farhan10904/lightweight-motor-bracket-fea/docs/01_Baseline_2D_Sketch.png

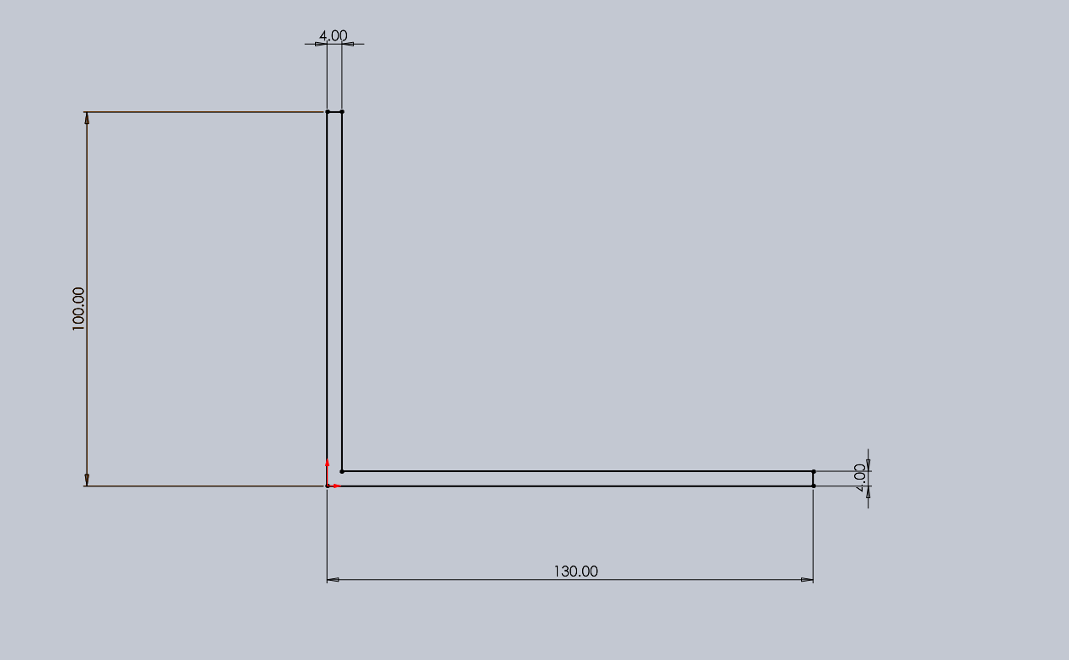
docs/01_Baseline_2D_Sketch.png
