farhan10904/lightweight-motor-bracket-fea/docs/09_Mass_Baseline_R0.png

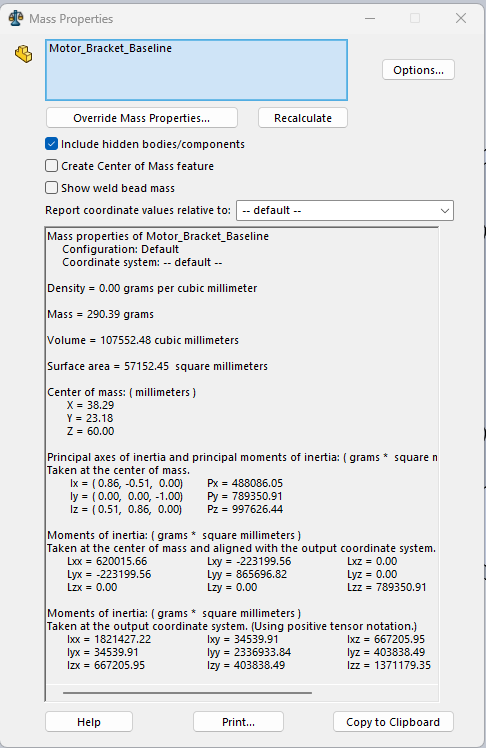
docs/09_Mass_Baseline_R0.png
