farhan10904/lightweight-motor-bracket-fea/docs/14_ANSYS_R0_Imported_Geometry.png

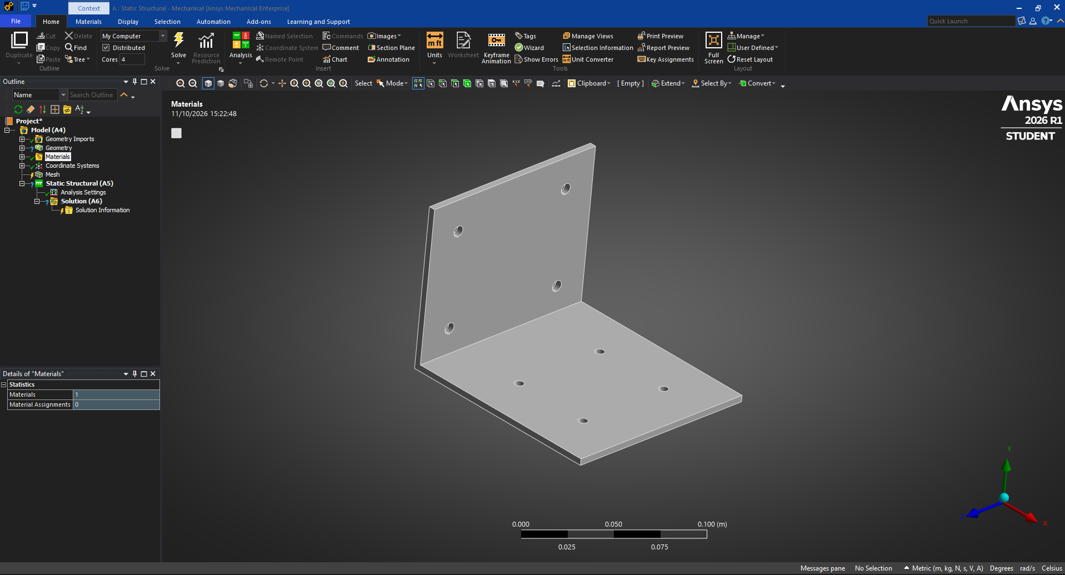
docs/14_ANSYS_R0_Imported_Geometry.png
