farhan10904/lightweight-motor-bracket-fea/docs/16_ANSYS_R0_Initial_Mesh.png

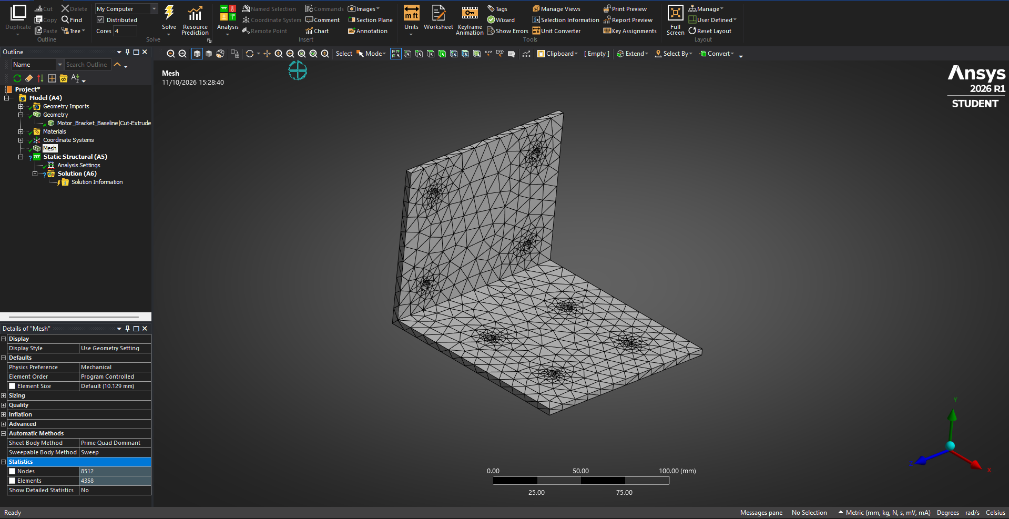
docs/16_ANSYS_R0_Initial_Mesh.png
