farhan10904/lightweight-motor-bracket-fea/docs/21_ANSYS_R0_Mesh_6mm.png

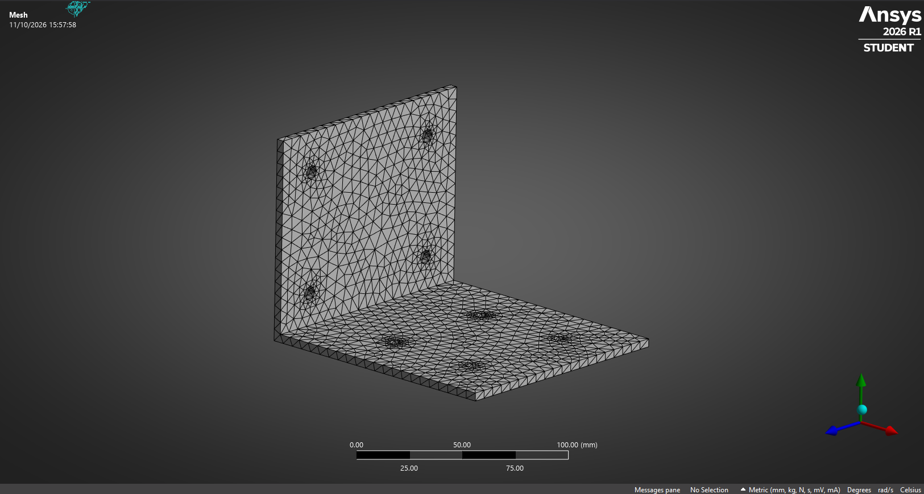
docs/21_ANSYS_R0_Mesh_6mm.png
