farhan10904/lightweight-motor-bracket-fea/docs/22_ANSYS_R0_6mm_Deformation.png

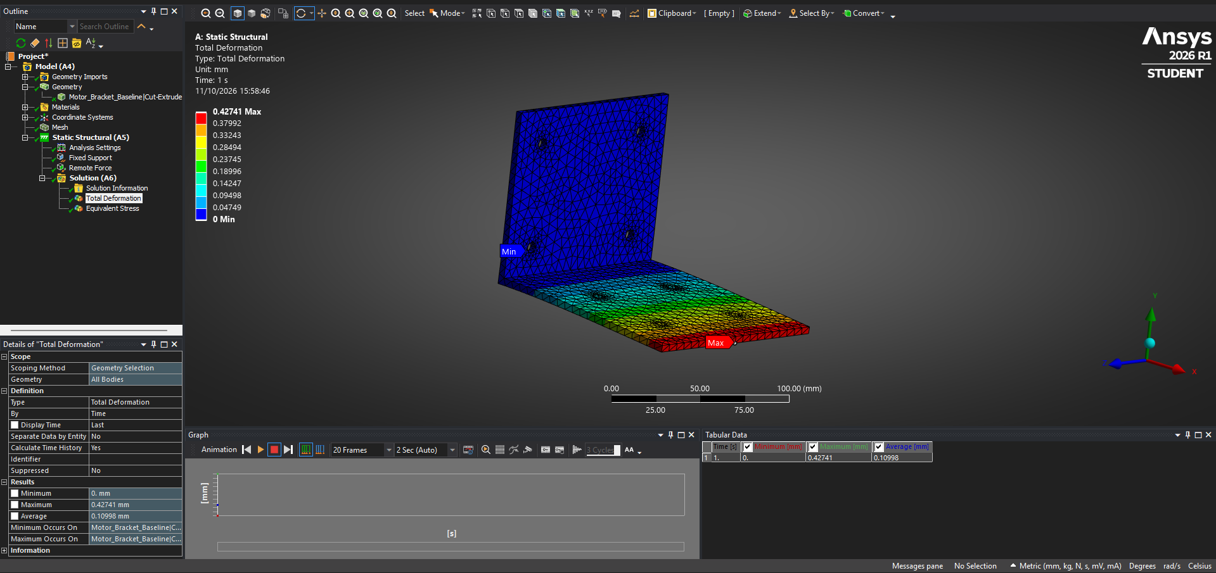
docs/22_ANSYS_R0_6mm_Deformation.png
