farhan10904/lightweight-motor-bracket-fea/docs/23_ANSYS_R0_6mm_Stress.png

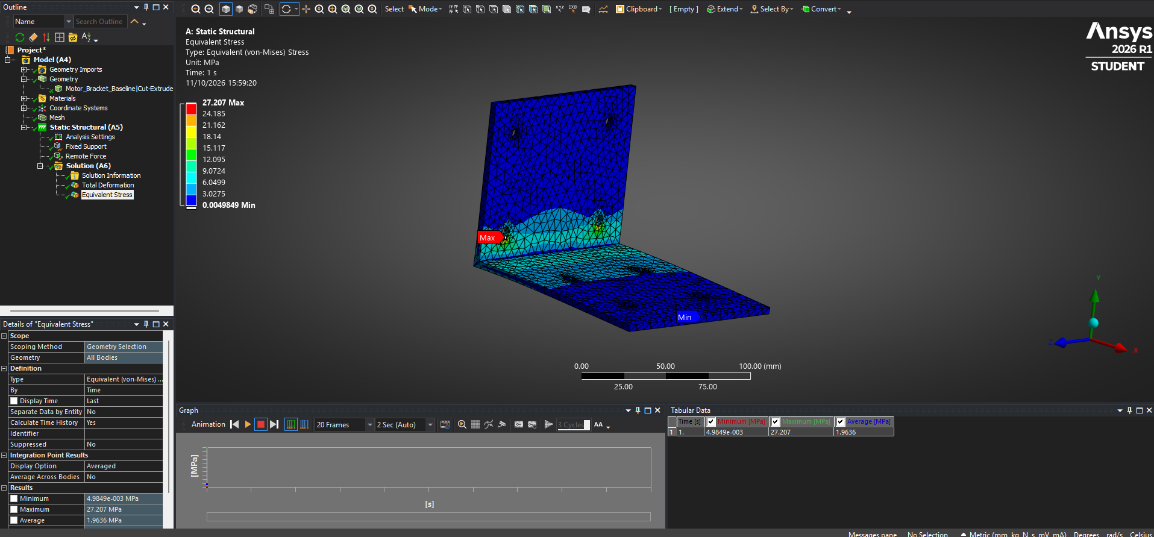
docs/23_ANSYS_R0_6mm_Stress.png
