farhan10904/lightweight-motor-bracket-fea/docs/24_ANSYS_R0_Mesh_4mm.png

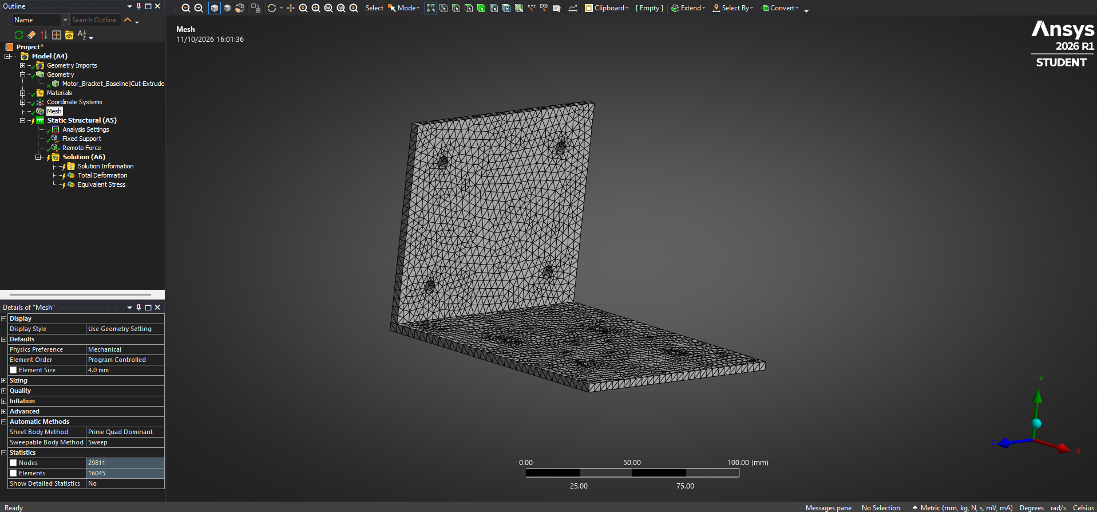
docs/24_ANSYS_R0_Mesh_4mm.png
