farhan10904/lightweight-motor-bracket-fea/docs/28_ANSYS_R2_4mm_Deformation.png

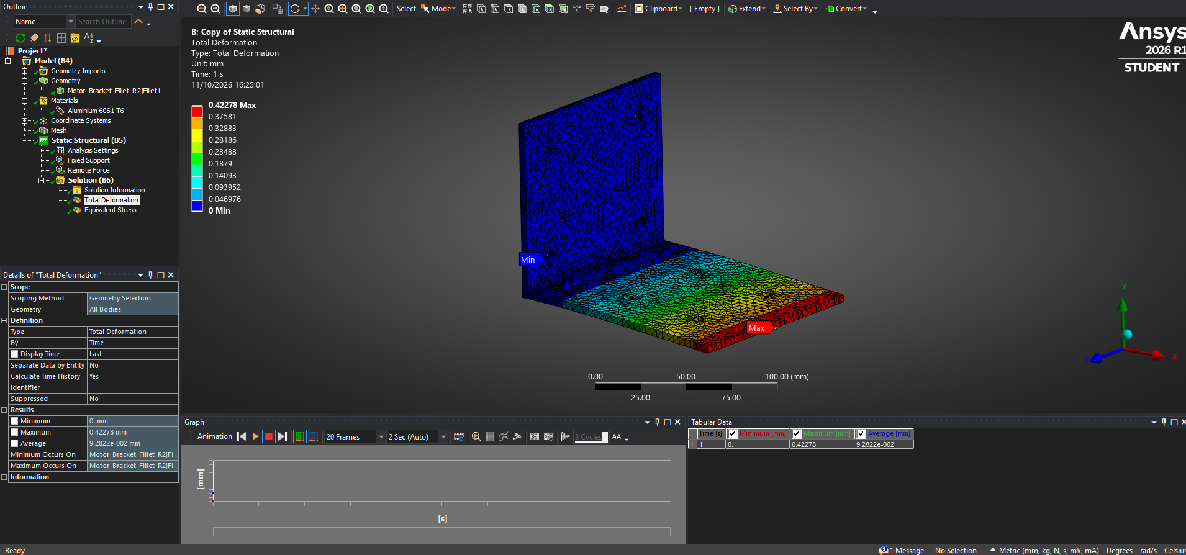
docs/28_ANSYS_R2_4mm_Deformation.png
