farhan10904/lightweight-motor-bracket-fea/docs/29_ANSYS_R2_4mm_Stress.png

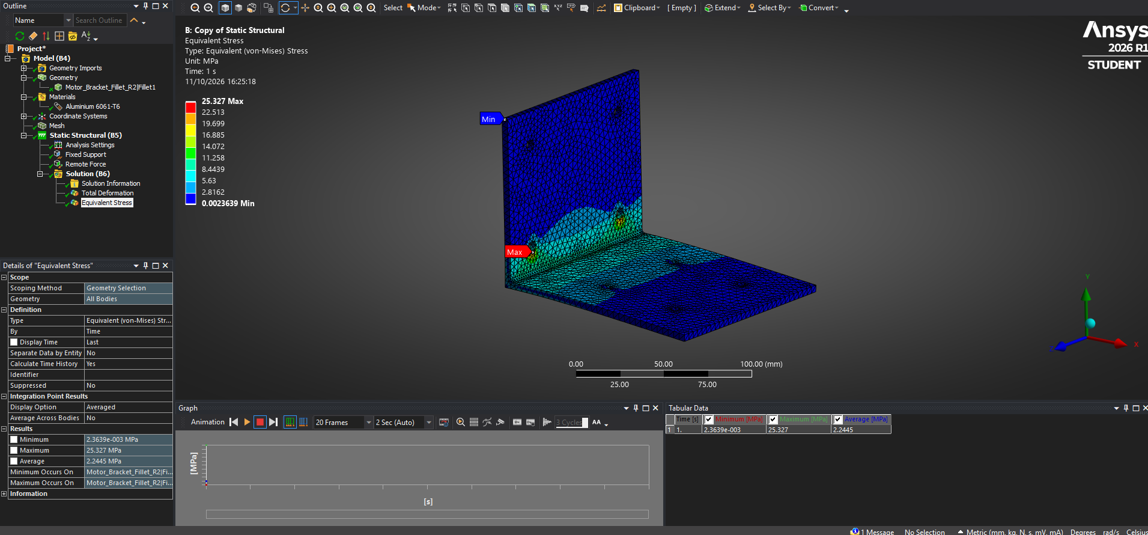
docs/29_ANSYS_R2_4mm_Stress.png
