farhan10904/lightweight-motor-bracket-fea/docs/30_ANSYS_R5_Mesh_4mm.png

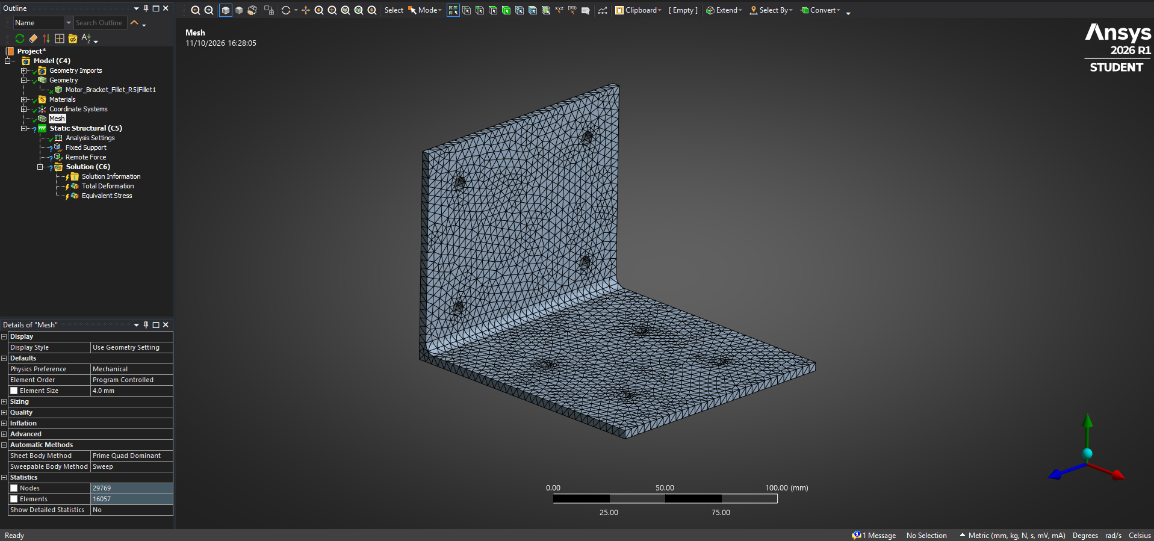
docs/30_ANSYS_R5_Mesh_4mm.png
