farhan10904/lightweight-motor-bracket-fea/docs/31_ANSYS_R5_Deformation_4mm.png

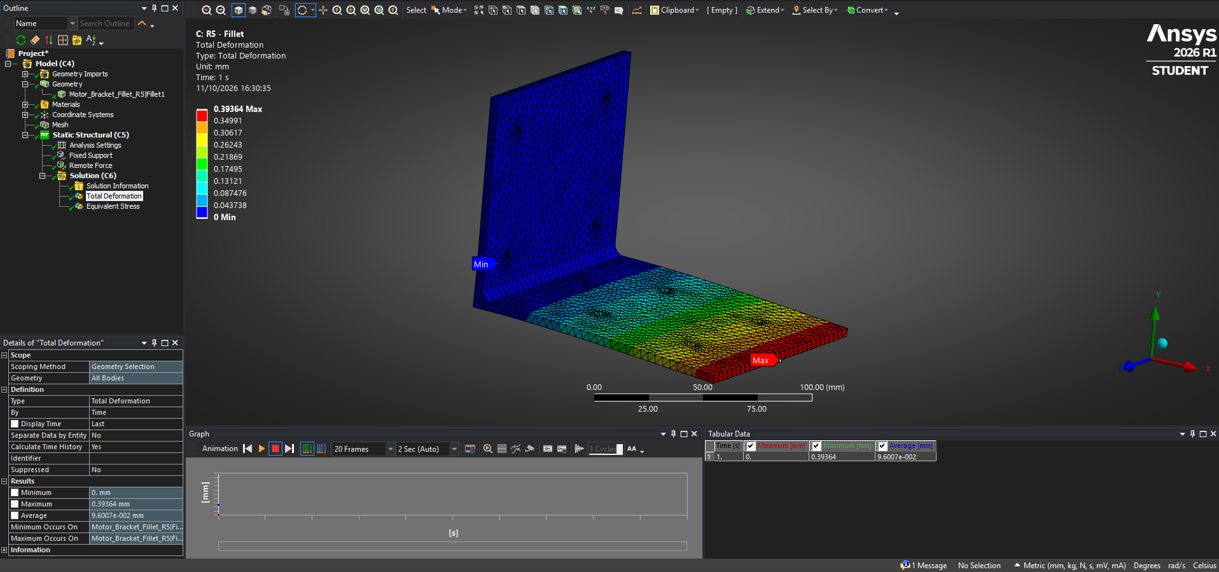
docs/31_ANSYS_R5_Deformation_4mm.png
