farhan10904/lightweight-motor-bracket-fea/docs/32_ANSYS_R5_Stress_4mm.png

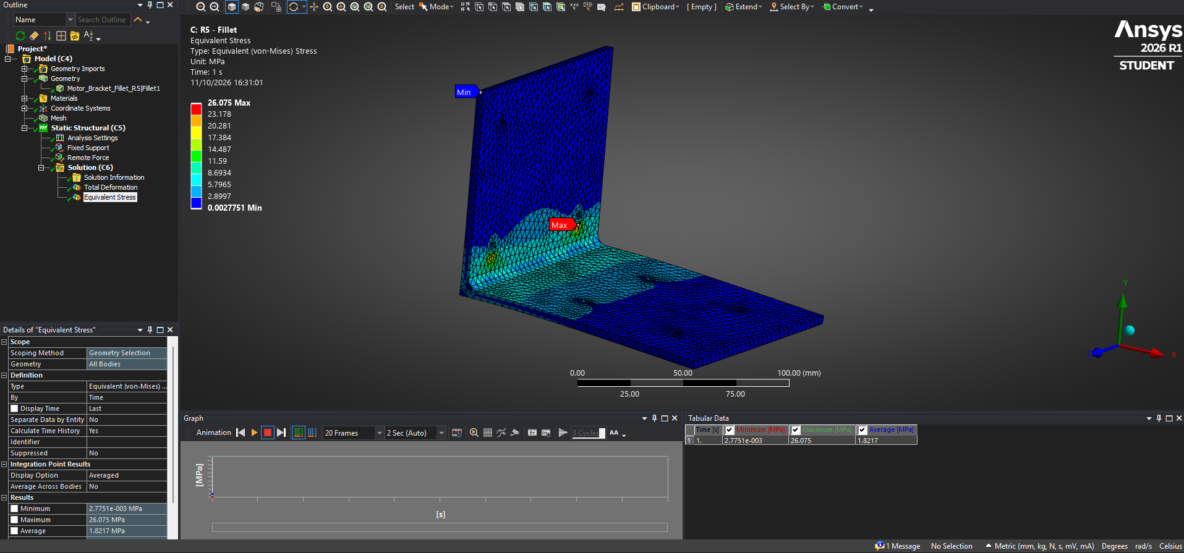
docs/32_ANSYS_R5_Stress_4mm.png
