farhan10904/lightweight-motor-bracket-fea/docs/33_ANSYS_R10_Mesh_4mm.png

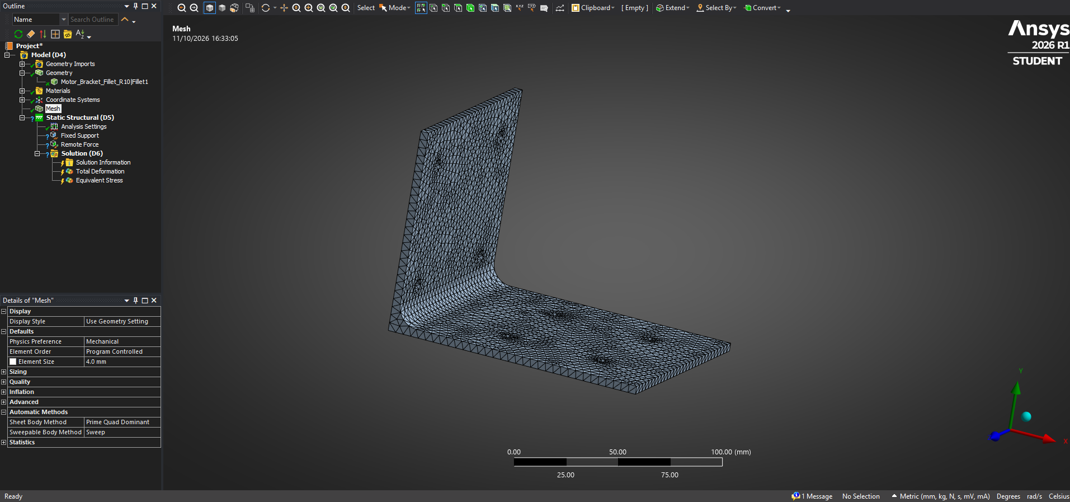
docs/33_ANSYS_R10_Mesh_4mm.png
