farhan10904/lightweight-motor-bracket-fea/docs/34_ANSYS_R10_Deformation_4mm.png

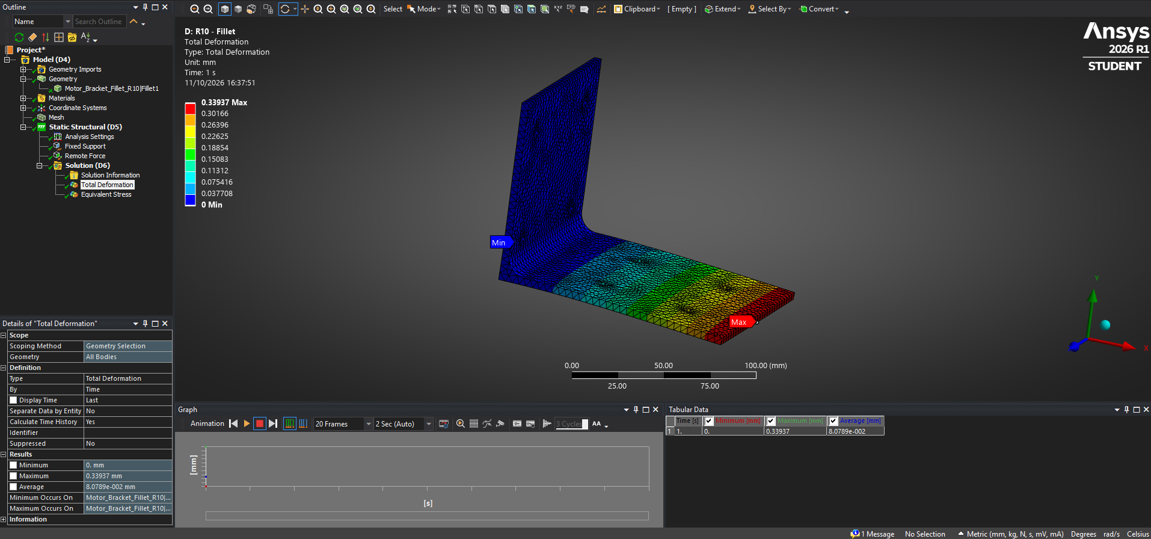
docs/34_ANSYS_R10_Deformation_4mm.png
