farhan10904/lightweight-motor-bracket-fea/docs/38_ANSYS_Parametric_R10_CAD.png

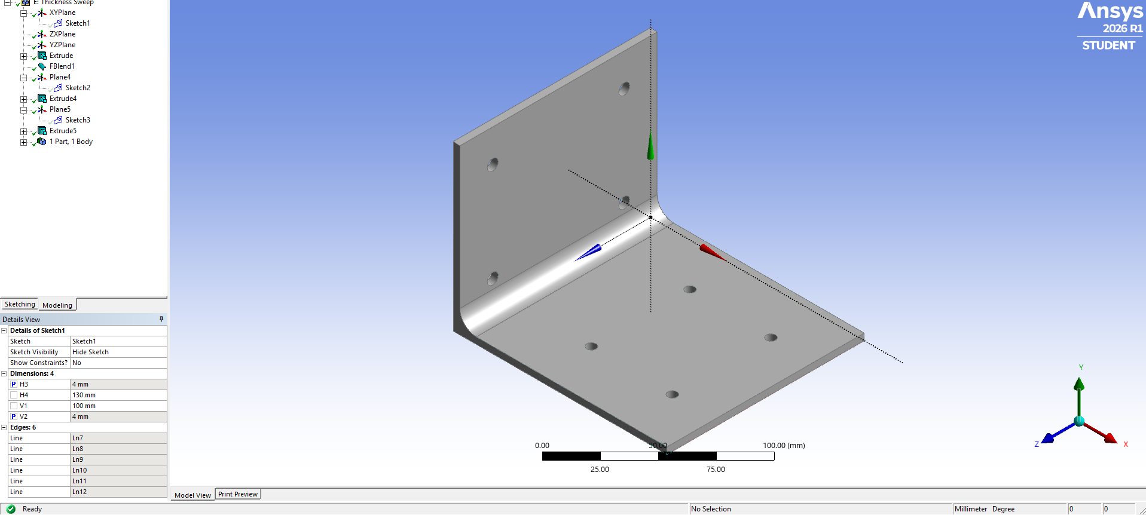
docs/38_ANSYS_Parametric_R10_CAD.png
