farhan10904/lightweight-motor-bracket-fea/docs/39_ANSYS_Thickness_Parametric_Sweep.png

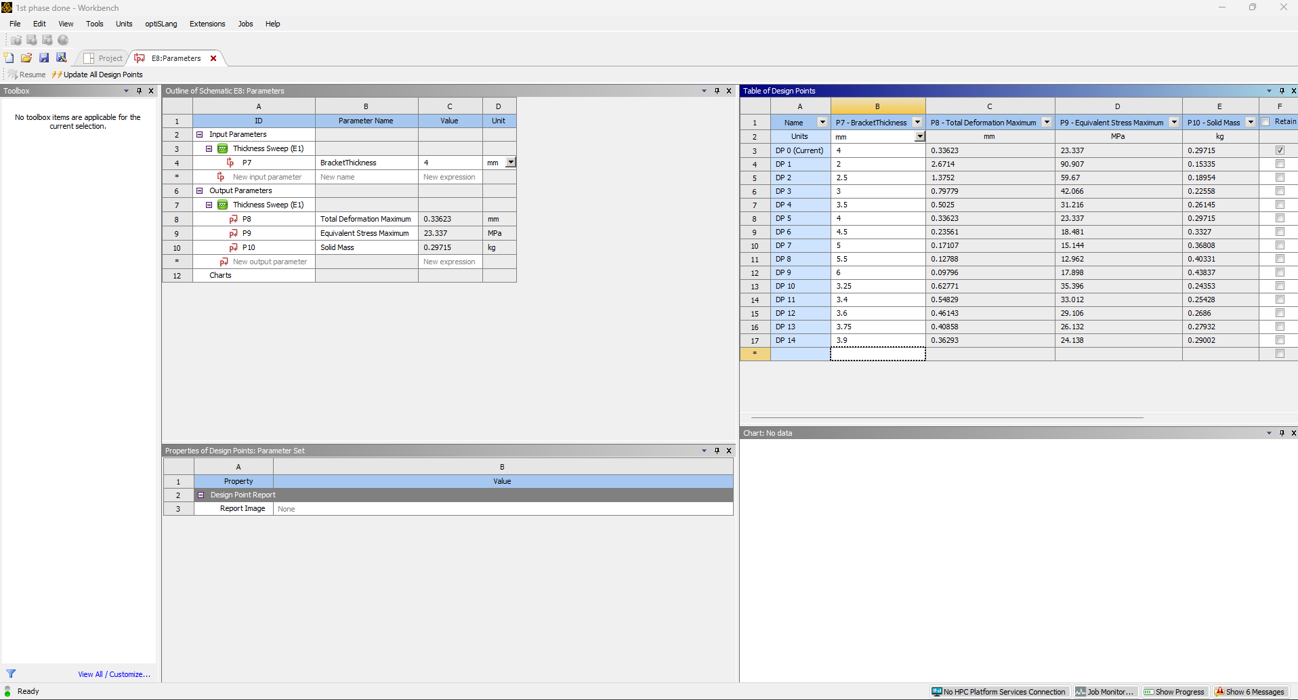
docs/39_ANSYS_Thickness_Parametric_Sweep.png
