farhan10904/lightweight-motor-bracket-fea/docs/08_Material_Properties_6061_T6.png

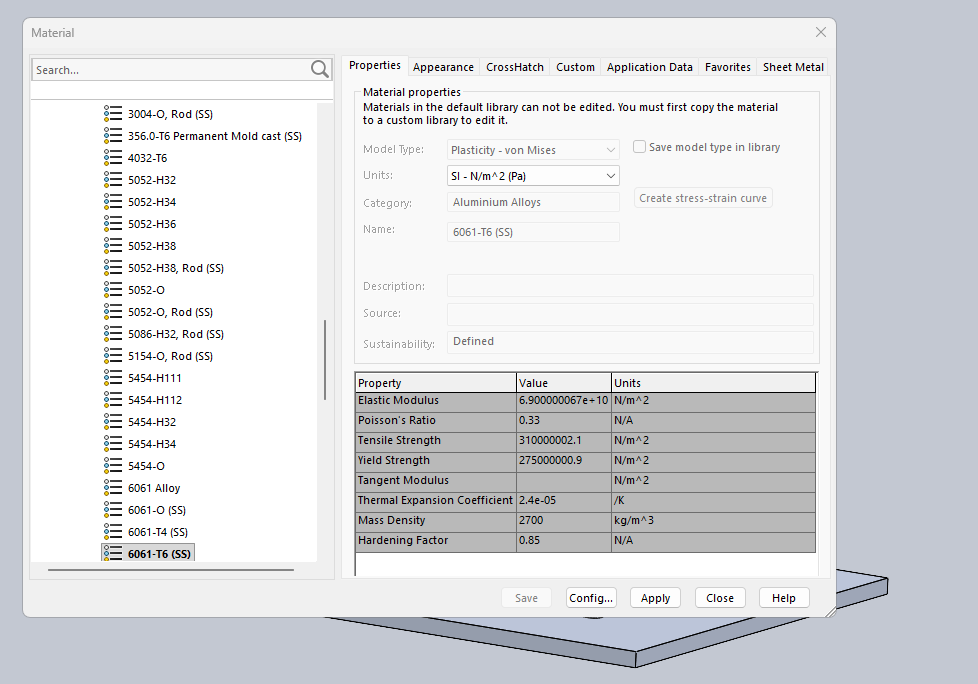
docs/08_Material_Properties_6061_T6.png
