farhan10904/lightweight-motor-bracket-fea/docs/13_ANSYS_Material_6061_T6.png

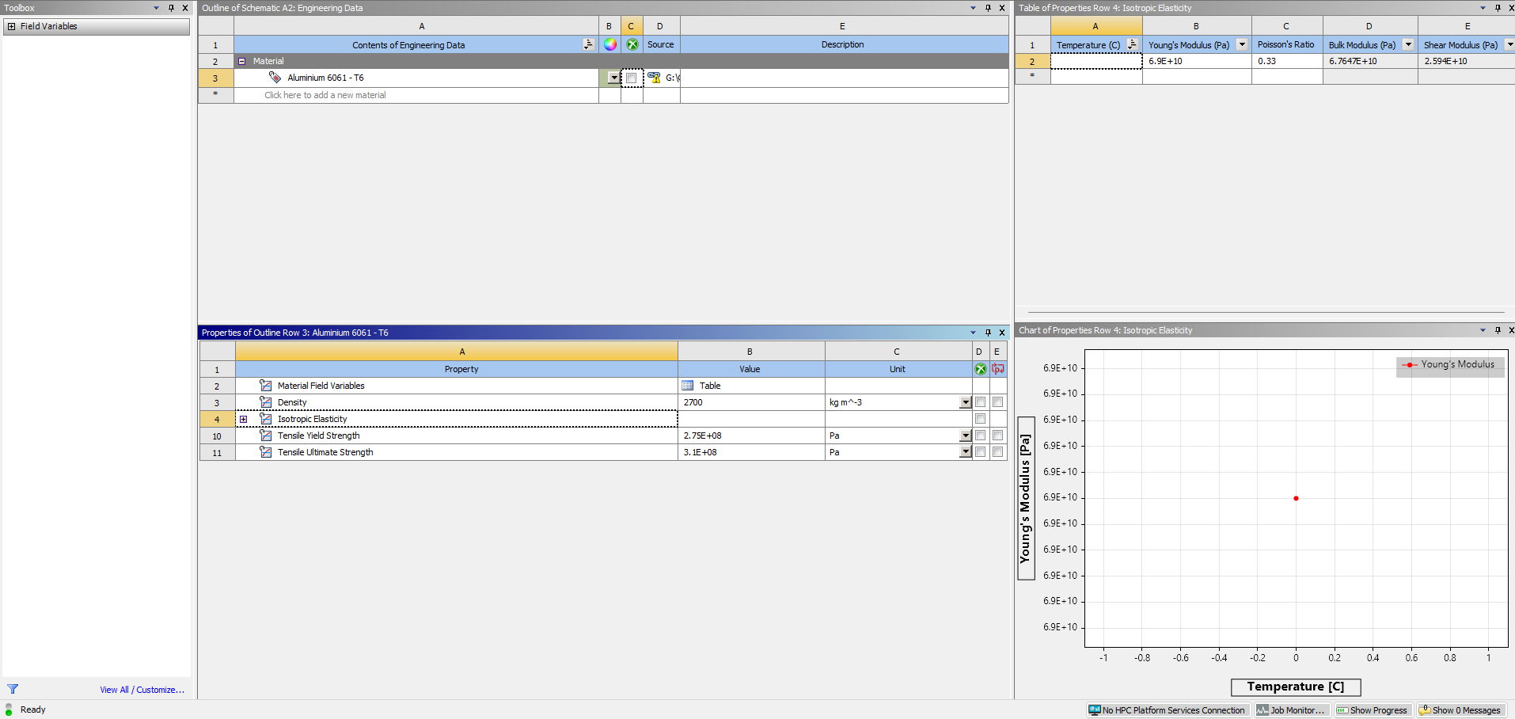
docs/13_ANSYS_Material_6061_T6.png
