farhan10904/lightweight-motor-bracket-fea/CAD/Motor_Bracket_Fillet_R2.STEP

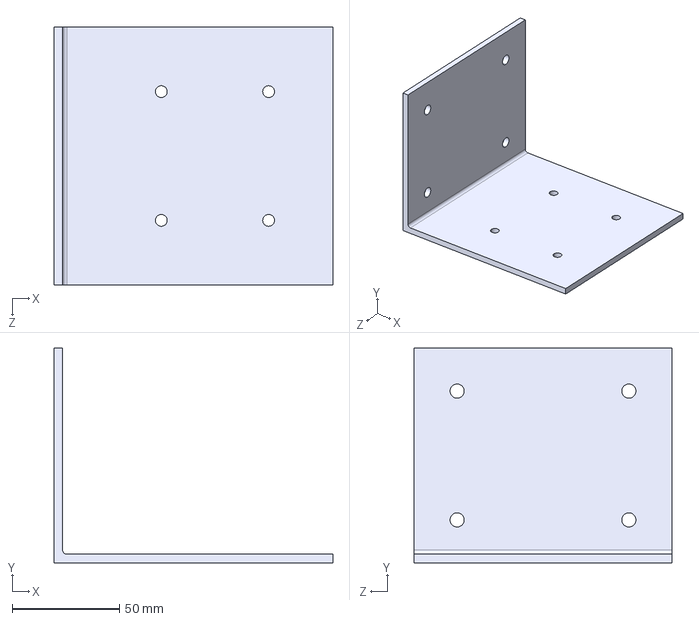
[picture p34: CAD file, 2026-10-11]
CAD/Motor_Bracket_Fillet_R2.STEP
130.0 x 100.0 x 120.0 mm
