farhan10904/lightweight-motor-bracket-fea/(list of files, cad)

Other CAD files:
CAD/Motor_Bracket_Fillet_R10.STEP
CAD/Motor_Bracket_Fillet_R5.STEP
CAD/Motor_Bracket_Baseline.STEP
CAD/Part1.SLDPRT
CAD/Motor_Bracket_Baseline.SLDPRT
CAD/Motor_Bracket_Fillet_R10.SLDPRT
CAD/Motor_Bracket_Fillet_R2.SLDPRT
CAD/Motor_Bracket_Fillet_R5.SLDPRT
