farhan10904/lightweight-motor-bracket-fea/Results/Thickness_Sweep_Results.csv

Design Point | Thickness (mm) | Maximum Deformation (mm) | Maximum von Mises Stress (MPa) | Solid Mass (kg) | Solid Mass (g) | Deflection Limit (mm) | Deflection Pass (sweep)
DP0 | 4.0 | 0.33623 | 23.337 | 0.29715 | 297.15 | 0.5 | PASS
DP1 | 2.0 | 2.6714 | 90.907 | 0.15335 | 153.35 | 0.5 | FAIL
DP2 | 2.5 | 1.3752 | 59.67 | 0.18954 | 189.54 | 0.5 | FAIL
DP3 | 3.0 | 0.79779 | 42.066 | 0.22558 | 225.58 | 0.5 | FAIL
DP4 | 3.5 | 0.5025 | 31.216 | 0.26145 | 261.45 | 0.5 | FAIL
DP5 | 4.0 | 0.33623 | 23.337 | 0.29715 | 297.15 | 0.5 | PASS
DP6 | 4.5 | 0.23561 | 18.481 | 0.3327 | 332.7 | 0.5 | PASS
DP7 | 5.0 | 0.17107 | 15.144 | 0.36808 | 368.08 | 0.5 | PASS
DP8 | 5.5 | 0.12788 | 12.962 | 0.40331 | 403.31 | 0.5 | PASS
DP9 | 6.0 | 0.09796 | 17.898 | 0.43837 | 438.37 | 0.5 | PASS
DP10 | 3.25 | 0.62771 | 35.396 | 0.24353 | 243.53 | 0.5 | FAIL
DP11 | 3.4 | 0.54829 | 33.012 | 0.25428 | 254.28 | 0.5 | FAIL
DP12 | 3.6 | 0.46143 | 29.106 | 0.2686 | 268.6 | 0.5 | PASS
DP13 | 3.75 | 0.40858 | 26.132 | 0.27932 | 279.32 | 0.5 | PASS
DP14 | 3.9 | 0.36293 | 24.138 | 0.29002 | 290.02 | 0.5 | PASS
