farhan10904/lightweight-motor-bracket-fea/(commit log)

2026-10-11 finished the project with plenty of files, and pictures
    [Mesh_Verification_3p6mm.csv, Motor_Bracket_Baseline.SLDPRT, Motor_Bracket_Baseline.STEP, Motor_Bracket_Fillet_R10.SLDPRT, Motor_Bracket_Fillet_R10.STEP, Motor_Bracket_Fillet_R2.SLDPRT, Motor_Bracket_Fillet_R2.STEP, Motor_Bracket_Fillet_R5.SLDPRT]
2026-10-11 finishing touches
    [Mesh_Verification_3p6mm.csv, Thickness_Sweep_Results.csv]
